GadgetReboot/Remote_Relay/README.md

# Remote_Relay
Remotely control a relay over WiFi or UART pins (use UART with a TTL to RS485 or Bluetooth module etc)
<br><br>
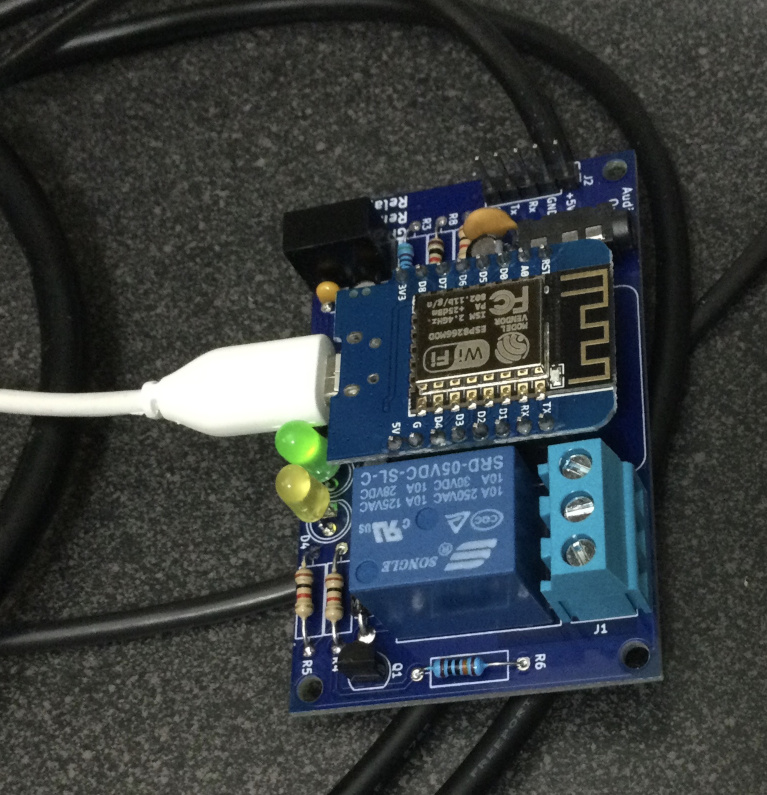
[picture p1: Assembled_PCB.jpg]
pcb
<br><br>
