GadgetReboot/Remote_Relay/sketches/BT_Fogger/readme.md

Control a fog machine via bluetooth.<br><br>
By connecting the fog machine's manual activation button to the relay contacts on the remote relay pcb, then connecting a bluetooth module to the pcb's uart header,
the fog machine can be controlled from bluetooth commands.<br><br>
