GadgetReboot/Remote_Relay/KiCAD/3D_Models/DG125-5.08-03P-14-00AH.STEP

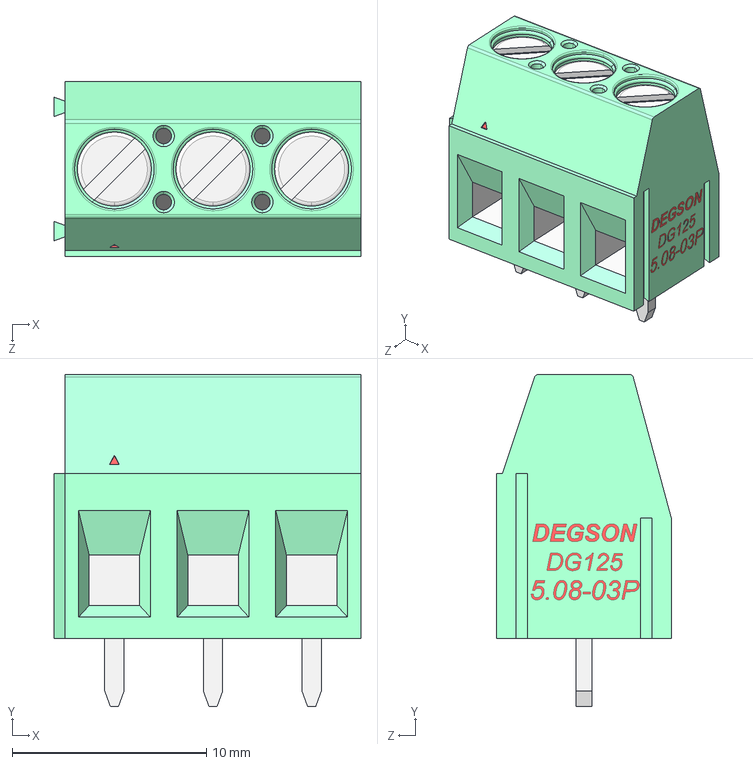
[picture p2: CAD file, 2022-10-22]
KiCAD/3D_Models/DG125-5.08-03P-14-00AH.STEP
15.8 x 17.1 x 9.00 mm
