GadgetReboot/Remote_Relay/GR_Remote_Relay-sch.pdf

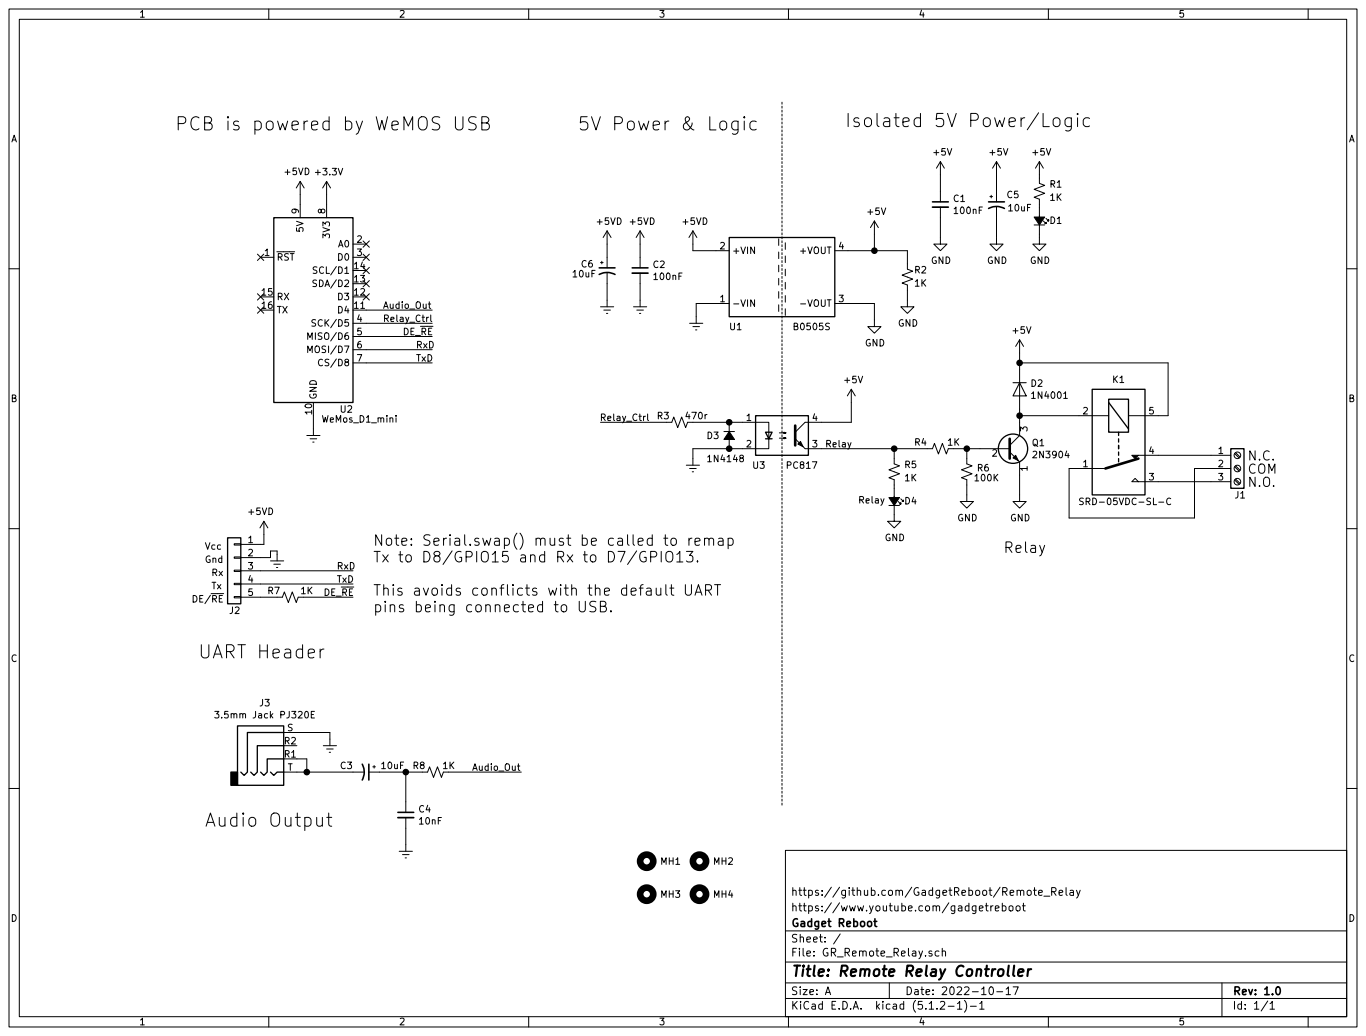
[picture p3: page 1]

+3.3V PCB is powered by WeMOS USB

Tx to D8/GPIO15 and Rx to D7/GPIO13.

RxD
TxD
This avoids conflicts with the default UART
pins being connected to USB.

https://github.com/GadgetReboot/Remote_Relay
https://www.youtube.com/gadgetreboot
File: GR_Remote_Relay.sch Sheet: / Gadget Reboot

Id: 1/1 Title: Remote Relay Controller
