GadgetReboot/Remote_Relay/KiCAD/GR_Remote_Relay.kicad_pcb

## KiCad design KiCAD/GR_Remote_Relay.kicad_pcb (2022-10-22)

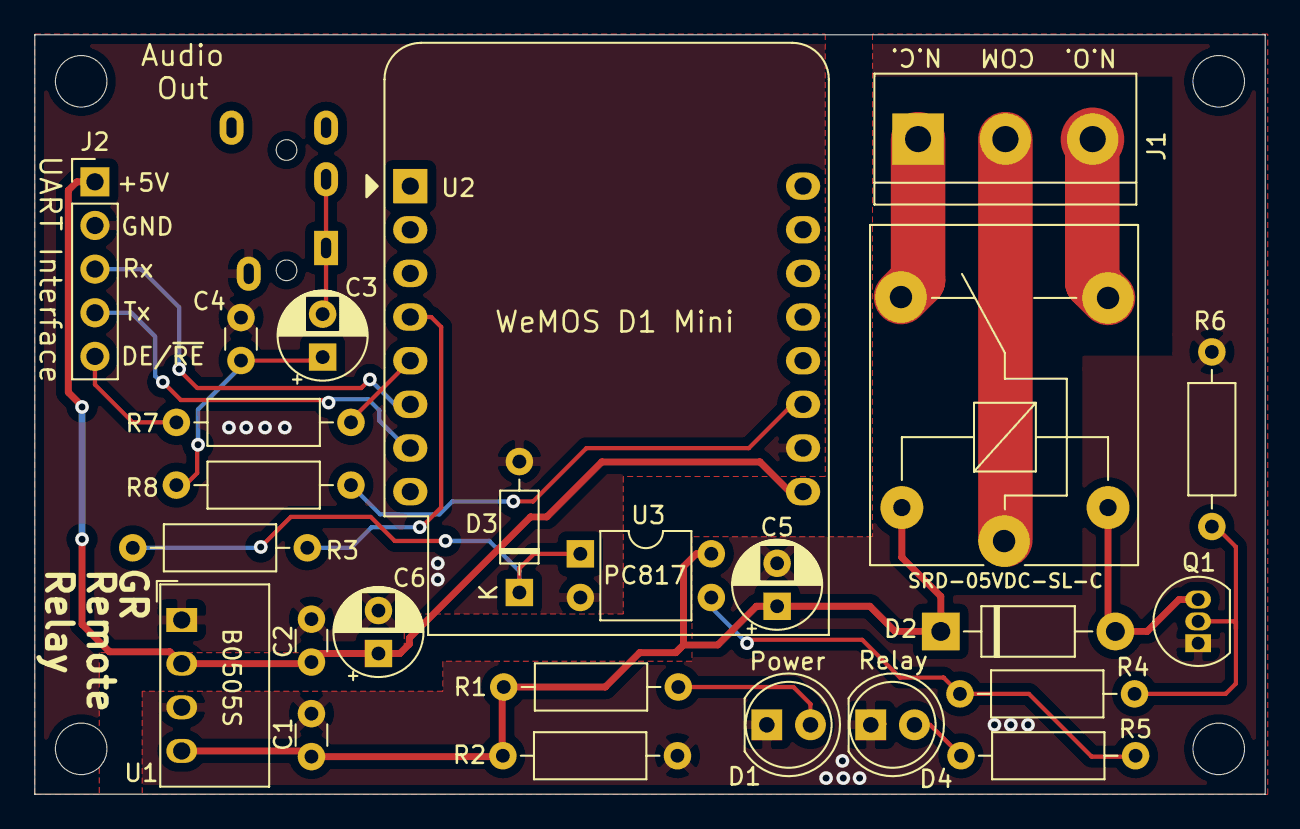
[picture p4: board GR_Remote_Relay.kicad_pcb from above]

Board: 2 copper layers, 71.6 x 44.2 mm, 30 parts (1 on the bottom side), 21 nets.

Parts:
C1, C2: 100nF; C_Disc_D3.0mm_W1.6mm_P2.50mm
C3, C5, C6: 10uF; CP_Radial_D5.0mm_P2.50mm
C4: 10nF; C_Disc_D3.0mm_W1.6mm_P2.50mm
D1, D4: LED_Small_ALT; LED_D5.0mm
D2: 1N4001; D_DO-41_SOD81_P10.16mm_Horizontal
D3: 1N4148; D_DO-35_SOD27_P7.62mm_Horizontal
J1: Screw_Terminal_01x03; TerminalBlock_bornier-3_P5.08mm
J2: Conn_01x05; PinHeader_1x05_P2.54mm_Vertical
J3: 3.5mm Jack PJ320E; Jack_3.5mm_PJ320E_Horizontal
K1: SRD-05VDC-SL-C; Relay_SPDT_SANYOU_SRD_Series_Form_C
MH1, MH2, MH3, MH4: MountingHole; MountingHole_3mm
Q1: 2N3904; TO-92_Inline
R1, R2, R4, R5, R7, R8: 1K; R_Axial_DIN0207_L6.3mm_D2.5mm_P10.16mm_Horizontal
R3: 470r; R_Axial_DIN0207_L6.3mm_D2.5mm_P10.16mm_Horizontal
R6: 100K; R_Axial_DIN0207_L6.3mm_D2.5mm_P10.16mm_Horizontal
U1: B0505S; Converter_DCDC_muRata_CRE1xxxxxx3C_THT
U2: WeMos_D1_mini; WEMOS_D1_mini_light
U3: PC817; DIP-4_W7.62mm

Connections:
+5V: C1.1, C5.1, D2.1, K1.5, R1.2, R2.2, U1.4, U3.4
+5VD: C2.1, C6.1, J2.1, U1.2, U2.9
/Audio_Out: R8.1, U2.11
/DE_~RE: R7.1, U2.5
/Relay: R4.2, R5.2, U3.3
/Relay_Ctrl: R3.2, U2.4
/RxD: J2.3, U2.6
/TxD: J2.4, U2.7
GND: C1.2, C5.2, D1.1, D4.1, Q1.1, R2.1, R6.1, U1.3
GNDREF: C2.2, C4.2, C6.2, D3.2, J2.2, J3.S, U1.1, U2.10, U3.2
unnamed: C3.1, C4.1, R8.2
unnamed: C3.2, J3.R1, J3.T
unnamed: D1.2, R1.1
unnamed: D2.2, K1.2, Q1.3
unnamed: D3.1, R3.1, U3.1
unnamed: D4.2, R5.1
unnamed: J1.1, K1.4
unnamed: J1.2, K1.1
unnamed: J1.3, K1.3
unnamed: J2.5, R7.2
unnamed: Q1.2, R4.1, R6.2
